amatus/rfidbadge/README.md

# RFID badge for DEF CON

## Controls

Press MENU to enter the menu system and to advance the selection.
Press SELECT to activate the selection.

Hold MENU to adjust the LCD contrast down (if the screen is all black).
Hold SELECT to adjust the LCD contrast up (if the screen is too light).
