amatus/rfidbadge/rfidbadge.brd

## EAGLE design rfidbadge.brd (2016-07-03)

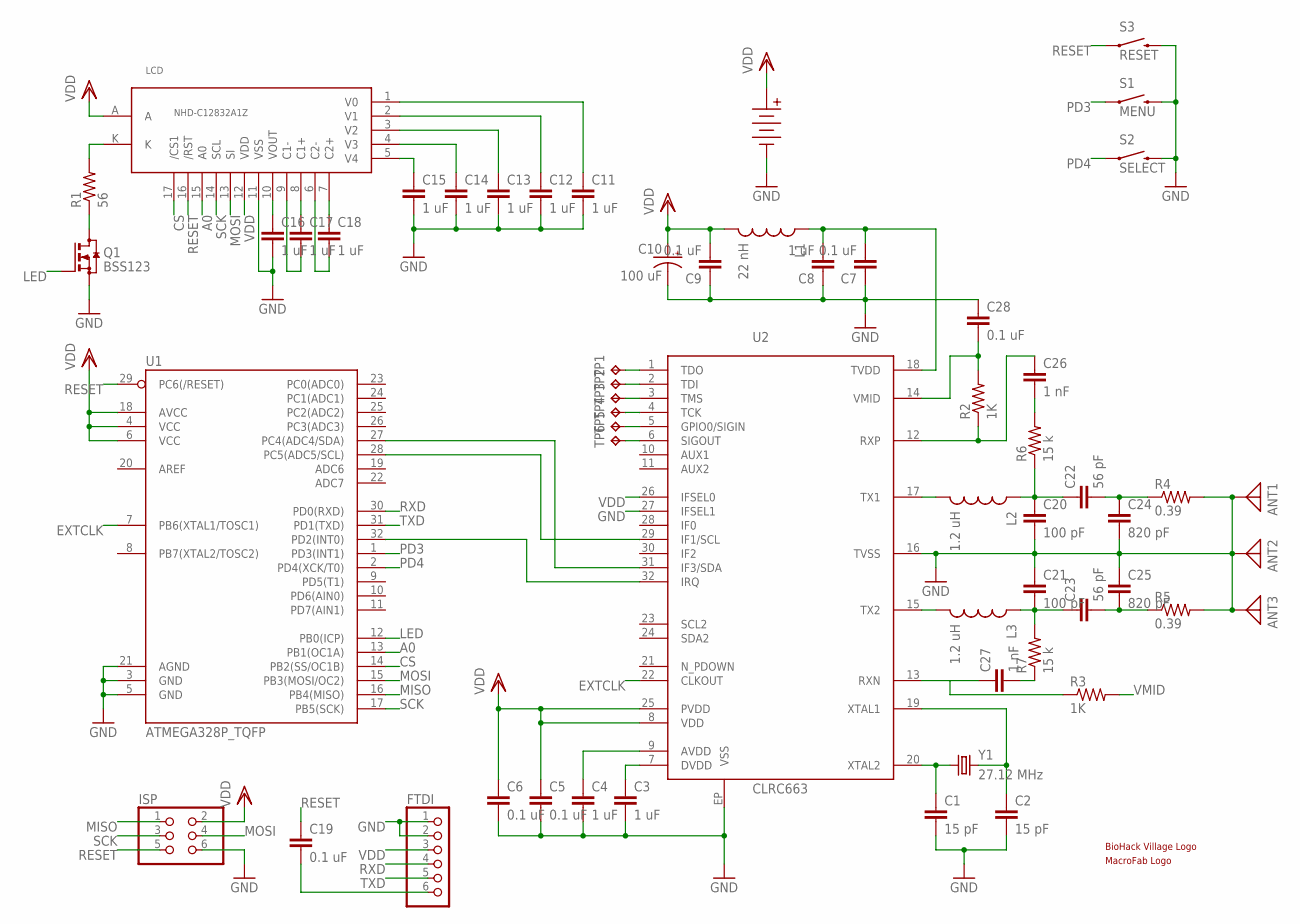
[picture p1: schematic rfidbadge.sch]

Parts:
ANT1, ANT2, ANT3: ANTENNA; PAD-01
BAT: AAA_X3
C1, C2: 15 pF; C0603K
C3, C4, C8, C11, C12, C13, C14, C15, C16, C17, C18: 1 uF; C0603K
C5, C6, C7, C9, C19, C28: 0.1 uF; C0603K
C10: 100 uF; EIA7343
C20, C21: 100 pF; C0603K
C22, C23: 56 pF; C0603K
C24, C25: 820 pF; C0603K
C26, C27: 1 nF; C0603K
FTDI: PINHD-1X6; 1X06
ISP: PINHD-2X3; 2X03
L1: 22 nH; 0603
L2, L3: 1.2 uH; 0603
LCD: NHD-C12832A1Z
Q1: BSS123; SOT23
R1: 56; R0603
R2, R3: 1K; R0603
R4, R5: 0.39; R0603
R6, R7: 15 k; R0603
S1: MENU; TACTILE_SWITCH_TALL
S2: SELECT; TACTILE_SWITCH_TALL
S3: RESET; TACTILE-SWITCH-1101NE
TP1, TP2, TP3, TP4, TP5, TP6: TPTP06R; TP06R
U1: ATMEGA328P_TQFP; TQFP32-08
U2: CLRC663; QFN32
U$1: BHVLOGO
U$2: MACROFABLOGO
Y1: 27.12 MHz; CRYSTAL-SMD-5X3

Connections:
A0: LCD.15 (A0), U1.13 (PB1(OC1A))
C1+: C17.1, LCD.8 (C1+)
C1-: C17.2, LCD.9 (C1-)
C2+: C18.1, LCD.7 (C2+)
C2-: C18.2, LCD.6 (C2-)
CS: LCD.17 (/CS1), U1.14 (PB2(SS/OC1B))
EXTCLK: U1.7 (PB6(XTAL1/TOSC1)), U2.22 (CLKOUT)
GND: ANT1.1, ANT2.1, ANT3.1, BAT.NEG, C1.2, C2.2, C3.2, C4.2, C5.2, C6.2, C7.1, C8.1, C9.1, C10.C (-), C11.2, C12.2, C13.2, C14.2, C15.2, C16.2, C20.2, C21.1, C24.2, C25.1, C28.1, FTDI.1, FTDI.2, ISP.6, LCD.11 (VSS), Q1.2 (S), R4.2, R5.2, S1.B2 (2), S2.B2 (2), S3.2, U1.3 (GND), U1.5 (GND), U1.21 (AGND), U2.16 (TVSS), U2.27 (IFSEL1), U2.EP (VSS)
K: LCD.K, R1.2
LED: Q1.1 (G), U1.12 (PB0(ICP))
MISO: ISP.1, U1.16 (PB4(MISO))
MOSI: ISP.4, LCD.13 (SI), U1.15 (PB3(MOSI/OC2))
unnamed: C20.1, C22.1, L2.1, R6.1
unnamed: C21.2, C23.1, L3.1, R7.2
unnamed: C22.2, C24.1, R4.1
unnamed: C23.2, C25.2, R5.1
unnamed: TP1.TP, U2.1 (TDO)
unnamed: TP2.TP, U2.2 (TDI)
unnamed: C26.2, R6.2
unnamed: C27.2, R7.1
unnamed: C27.1, R3.1, U2.13 (RXN)
unnamed: C4.1, U2.9 (AVDD)
unnamed: C3.1, U2.7 (DVDD)
unnamed: TP3.TP, U2.3 (TMS)
unnamed: TP4.TP, U2.4 (TCK)
unnamed: TP5.TP, U2.5 (GPIO0/SIGIN)
unnamed: TP6.TP, U2.6 (SIGOUT)
unnamed: Q1.3 (D), R1.1
unnamed: C19.2, FTDI.6
PD2: U1.32 (PD2(INT0)), U2.32 (IRQ)
PD3: S1.A2 (1), U1.1 (PD3(INT1))
PD4: S2.A2 (1), U1.2 (PD4(XCK/T0))
RESET: C19.1, ISP.5, LCD.16 (/RST), S3.1, U1.29 (PC6(/RESET))
RXD: FTDI.4, U1.30 (PD0(RXD))
RXP: C26.1, R2.1, U2.12 (RXP)
SCK: ISP.3, LCD.14 (SCL), U1.17 (PB5(SCK))
SCL: U1.28 (PC5(ADC5/SCL)), U2.29 (IF1/SCL)
SDA: U1.27 (PC4(ADC4/SDA)), U2.31 (IF3/SDA)
TVDD: C7.2, C8.2, L1.1, U2.18 (TVDD)
TX1: L2.2, U2.17 (TX1)
TX2: L3.2, U2.15 (TX2)
TXD: FTDI.5, U1.31 (PD1(TXD))
V0: C11.1, LCD.1 (V0)
V1: C12.1, LCD.2 (V1)
V2: C13.1, LCD.3 (V2)
V3: C14.1, LCD.4 (V3)
V4: C15.1, LCD.5 (V4)
VDD: BAT.POS, C5.1, C6.1, C9.2, C10.A (+), FTDI.3, ISP.2, L1.2, LCD.12 (VDD), LCD.A, U1.4 (VCC), U1.6 (VCC), U1.18 (AVCC), U2.8 (VDD), U2.25 (PVDD), U2.26 (IFSEL0)
VMID: C28.2, R2.2, R3.2, U2.14 (VMID)
VOUT: C16.1, LCD.10 (VOUT)
XTAL1: C2.1, U2.19 (XTAL1), Y1.3 (2)
XTAL2: C1.1, U2.20 (XTAL2), Y1.1

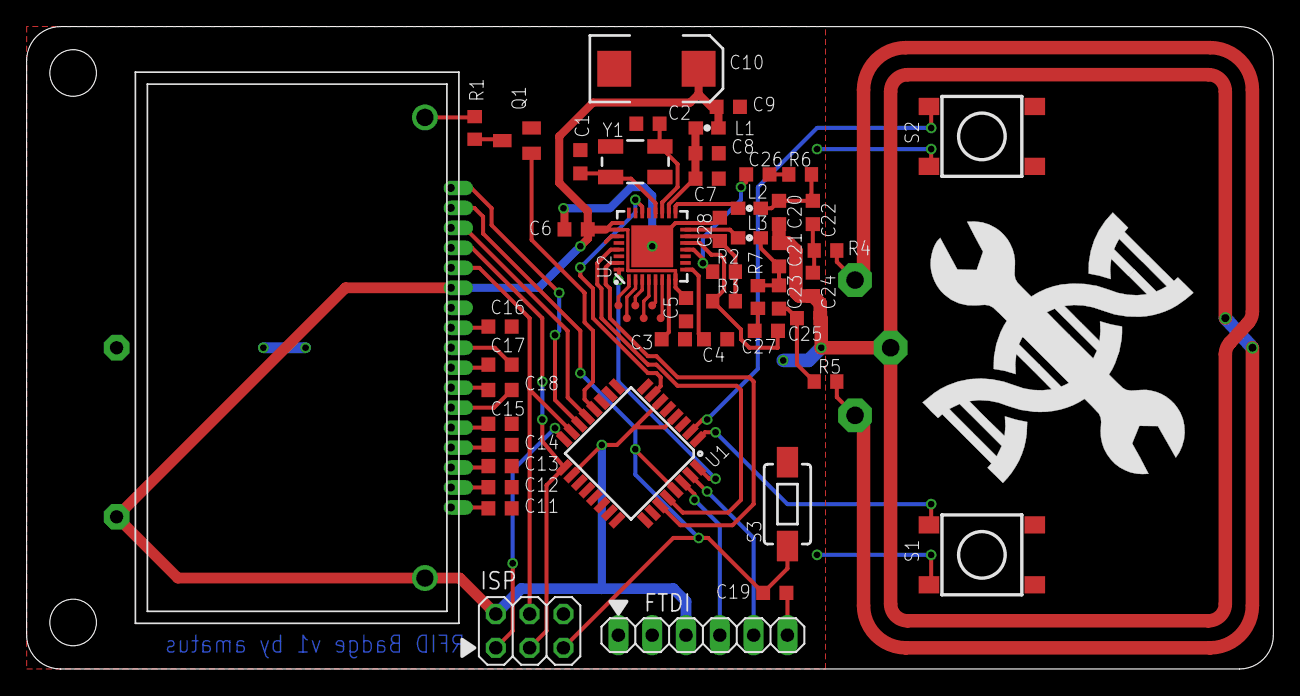
[picture p2: board rfidbadge.brd from above]

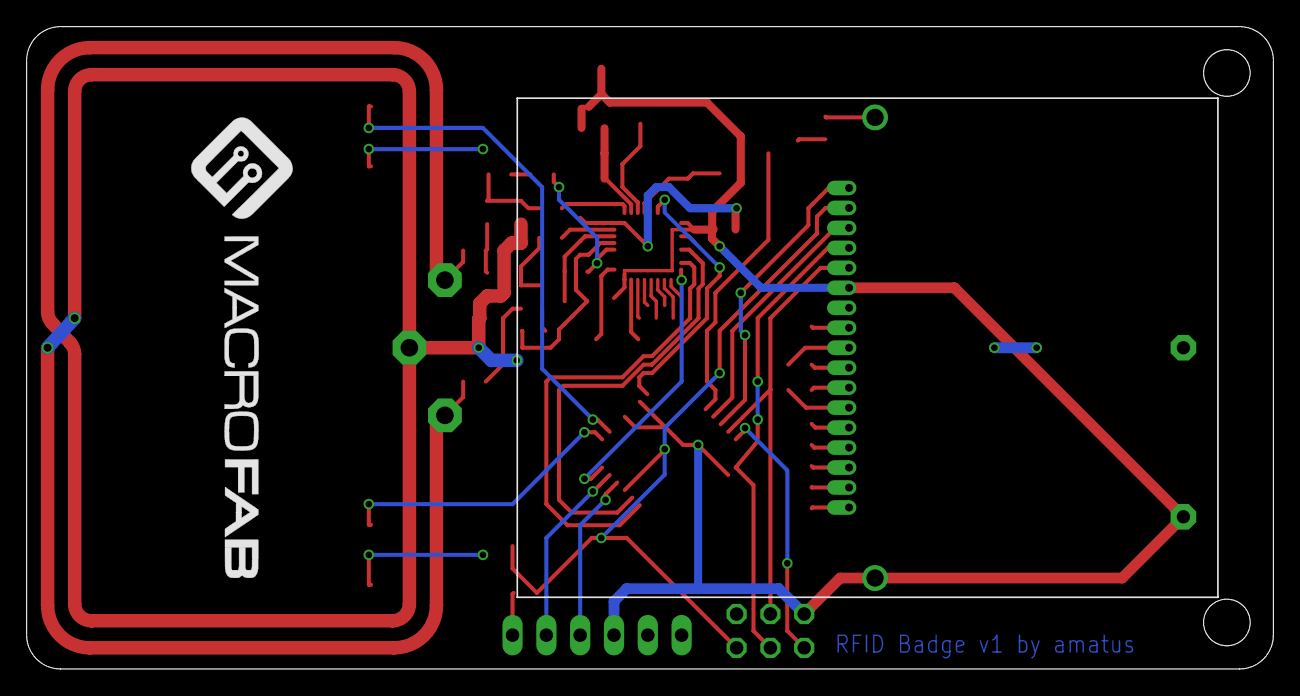
[picture p3: board rfidbadge.brd from below]

Board: 2 copper layers, 93.7 x 48.2 mm, 60 parts (2 on the bottom side), 52 nets.
