amatus/rfidbadge/programmer/program.h

0x940C,0x02E2,0x940C,0x030A,0x940C,0x030A,0x940C,0x030A,
0x940C,0x030A,0x940C,0x030A,0x940C,0x030A,0x940C,0x030A,
0x940C,0x030A,0x940C,0x030A,0x940C,0x030A,0x940C,0x030A,
0x940C,0x030A,0x940C,0x030A,0x940C,0x030A,0x940C,0x030A,
0x940C,0x0E95,0x940C,0x030A,0x940C,0x104D,0x940C,0x1090,
0x940C,0x030A,0x940C,0x030A,0x940C,0x030A,0x940C,0x030A,
0x940C,0x0CA7,0x940C,0x030A,0x0000,0x0000,0x7C00,0xF2DA,
0x7CDA,0xD67C,0xD6F2,0x387C,0x3E7C,0x387C,0x3C18,0x3C7E,
0x3818,0xBEEA,0x38EA,0x7A38,0x7AFE,0x0038,0x3C18,0x0018,
0xE7FF,0xE7C3,0x00FF,0x2418,0x0018,0xE7FF,0xE7DB,0x0CFF,
0x5C12,0x7060,0x9464,0x949E,0x0264,0xA0FE,0xE0A0,0xFE02,
0xA4A0,0x5AFC,0xE73C,0x5A3C,0x7CFE,0x3838,0x1010,0x3838,
0xFE7C,0x4428,0x44FE,0xFA28,0x00FA,0xFAFA,0x9060,0x80FE,
0x00FE,0x9166,0x56A9,0x0606,0x0606,0x2906,0xFF45,0x2945,
0x2010,0x207E,0x0810,0x7E04,0x0804,0x1010,0x3854,0x1010,
0x5438,0x1010,0x0878,0x0808,0x3008,0x3078,0x3078,0x1C0C,
0x1C7C,0x600C,0x7C70,0x6070,0x0000,0x0000,0x0000,0xFA00,
0x0000,0xE000,0xE000,0x2800,0x28FE,0x28FE,0x5424,0x54FE,
0xC448,0x10C8,0x4626,0x926C,0x046A,0x000A,0xE010,0x00C0,
0x3800,0x8244,0x0000,0x4482,0x0038,0x3854,0x38FE,0x1054,
0x7C10,0x1010,0x0100,0x0C0E,0x1000,0x1010,0x1010,0x0000,
0x0606,0x0400,0x1008,0x4020,0x8A7C,0xA292,0x007C,0xFE42,
0x0002,0x924E,0x9292,0x8462,0x9282,0xCCB2,0x2818,0xFE48,
0xE408,0xA2A2,0x9CA2,0x523C,0x9292,0x828C,0x8884,0xE090,
0x926C,0x9292,0x626C,0x9292,0x7894,0x0000,0x0028,0x0000,
0x2C02,0x0000,0x1000,0x4428,0x2882,0x2828,0x2828,0x8200,
0x2844,0x4010,0x9A80,0x6090,0x827C,0x9ABA,0x3E72,0x8848,
0x3E48,0x92FE,0x9292,0x7C6C,0x8282,0x4482,0x82FE,0x8282,
0xFE7C,0x9292,0x8292,0x90FE,0x9090,0x7C80,0x8282,0xCE8A,
0x10FE,0x1010,0x00FE,0xFE82,0x0082,0x0204,0xFC82,0xFE80,
0x2810,0x8244,0x02FE,0x0202,0xFE02,0x3840,0xFE40,0x20FE,
0x0810,0x7CFE,0x8282,0x7C82,0x90FE,0x9090,0x7C60,0x8A82,
0x7A84,0x90FE,0x9498,0x6462,0x9292,0x4C92,0x80C0,0x80FE,
0xFCC0,0x0202,0xFC02,0x04F8,0x0402,0xFCF8,0x1C02,0xFC02,
0x28C6,0x2810,0xC0C6,0x1E20,0xC020,0x9A86,0xB292,0x00C2,
0x82FE,0x8282,0x2040,0x0810,0x0004,0x8282,0xFE82,0x4020,
0x4080,0x0220,0x0202,0x0202,0xC000,0x10E0,0x0400,0x2A2A,
0x021E,0x14FE,0x2222,0x1C1C,0x2222,0x1422,0x221C,0x1422,
0x1CFE,0x2A2A,0x182A,0x1000,0x907E,0x1840,0x2525,0x1E39,
0x10FE,0x2020,0x001E,0xBE22,0x0002,0x0204,0xBC02,0xFE00,
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
