amatus/rfidbadge/programmer/bootloader.h

0x2411,0xB784,0xBE14,0xFF81,0xD0F0,0xE085,0x9380,0x0081,
0xE082,0x9380,0x00C0,0xE188,0x9380,0x00C1,0xE086,0x9380,
0x00C2,0xE180,0x9380,0x00C4,0xE08E,0xD0C9,0x9A25,0xE086,
0xE320,0xEF3C,0xE091,0x9330,0x0085,0x9320,0x0084,0xBB96,
0x9BB0,0xCFFE,0x9A1D,0x95A8,0x5081,0xF7A9,0x24CC,0x24DD,
0x2488,0x9483,0xE0B5,0x2EAB,0xE1A1,0x2E9A,0xE0F3,0x2EBF,
0xD0A2,0x3481,0xF461,0xD09F,0x2F08,0xD0AF,0x3802,0xF011,
0x3801,0xF411,0xE084,0xC001,0xE083,0xD08D,0xC089,0x3482,
0xF411,0xE184,0xC003,0x3485,0xF419,0xE085,0xD0A6,0xC080,
0x3585,0xF479,0xD088,0x2EE8,0x24FF,0xD085,0x2F08,0xE010,
0x2F10,0x2700,0x290E,0x291F,0x0F00,0x1F11,0xD08E,0x0168,
0xC06F,0x3586,0xF421,0xE084,0xD090,0xE080,0xCFDE,0x3684,
0xF009,0xC040,0xD070,0xD06F,0x2F08,0xD06D,0xE080,0x16C8,
0xE780,0x06D8,0xF418,0x01F6,0xBEB7,0x95E8,0xE0C0,0xE0D1,
0xD062,0x9389,0x170C,0xF7E1,0xE0F0,0x16CF,0xE7F0,0x06DF,
0xF018,0x01F6,0xBEB7,0x95E8,0xD068,0xB607,0xFC00,0xCFFD,
0x01A6,0xE0A0,0xE0B1,0x912C,0xE030,0x9611,0x918C,0x9711,
0xE090,0x2F98,0x2788,0x2B82,0x2B93,0x9612,0x01FA,0x010C,
0xBE87,0x95E8,0x2411,0x5F4E,0x4F5F,0xE0F1,0x38A0,0x07BF,
0xF751,0x01F6,0xBEA7,0x95E8,0xB607,0xFC00,0xCFFD,0xBE97,
0x95E8,0xC026,0x3784,0xF4B1,0xD02E,0xD02D,0x2EF8,0xD02B,
0xD03C,0x01F6,0x2CEF,0x018F,0x5F0F,0x4F1F,0x9184,0xD01B,
0x94EA,0x01F8,0xF7C1,0x9408,0x1CC1,0x1CD1,0x94FA,0x0CCF,
0x1CD1,0xC00E,0x3785,0xF439,0xD028,0xE18E,0xD00C,0xE985,
0xD00A,0xE08F,0xCF7A,0x3581,0xF411,0xE088,0xD018,0xD01D,
0xE180,0xD001,0xCF65,0x2F98,0x9180,0x00C0,0xFF85,0xCFFC,
0x9390,0x00C6,0x9508,0x9180,0x00C0,0xFF87,0xCFFC,0x9180,
0x00C0,0xFD84,0xC001,0x95A8,0x9180,0x00C6,0x9508,0xE6E0,
0xE0F0,0xE198,0x8390,0x8380,0x9508,0xDFED,0x3280,0xF019,
0xE088,0xDFF5,0xCFFF,0xE184,0xCFDE,0x931F,0x2F18,0xDFE3,
0x5011,0xF7E9,0xDFF2,0x911F,0x9508,0xE080,0xDFE8,0x27EE,
0x27FF,0x9409,
0x0404,
