amatus/rfidbadge/(commit log)

2016-05-03 ATmega328 and CLRC663 parts and a blank schematic
    [rfidbadge.sch]
2016-05-03 Wired up power and a crystal
    [rfidbadge.sch]
2016-05-03 Added display and wired up I2C
    [rfidbadge.sch]
2016-05-03 Add ISP and FTDI headers
    [rfidbadge.sch]
2016-05-04 Add antenna circuit
    [rfidbadge.sch]
2016-05-04 Add AAAx3 battery holder
    [rfidbadge.sch]
2016-05-04 Interrupted in the middle of starting the board
    [rfidbadge.brd, rfidbadge.sch]
2016-05-06 Lots of layout
    [rfidbadge.brd, rfidbadge.sch]
2016-05-10 Add antenna trace and ground planes
    [rfidbadge.brd, rfidbadge.sch]
2016-05-10 Finish routing
    [rfidbadge.brd, rfidbadge.sch]
2016-05-11 Add switches, lanyard holes, rounded corners
    [rfidbadge.brd, rfidbadge.sch]
2016-05-13 I like fat traces and I cannot lie
    [rfidbadge.brd]
2016-05-14 Added some test pads
    [rfidbadge.brd, rfidbadge.sch]
2016-05-15 Fix ground loops and islands
    [rfidbadge.brd]
2016-05-18 Fix button grounds
    [rfidbadge.brd]
2016-05-25 Some part values
    [rfidbadge.brd, rfidbadge.sch]
2016-05-25 Values and part numbers complete
    [rfidbadge.brd, rfidbadge.sch]
2016-05-26 Switch part number
    [rfidbadge.brd, rfidbadge.sch]
2016-05-28 Fix orphaned ground plane
    [rfidbadge.brd]
2016-06-03 Test Arduino sketch
2016-06-04 Send request type A and print results
2016-06-07 Adjust contrast for 4.5V
2016-06-08 Connect IRQ line, move buttons
    [rfidbadge.brd, rfidbadge.sch]
2016-06-08 Place part names
    [rfidbadge.brd]
2016-06-08 Add reset switch
    [rfidbadge.brd, rfidbadge.sch]
2016-06-10 Test buttons
2016-06-10 Make holes big enough for lobster claw
    [rfidbadge.brd]
2016-06-11 Add Defcon 24 logo
    [rfidbadge.brd, rfidbadge.sch]
2016-06-11 Fix artwork
    [rfidbadge.brd, rfidbadge.sch]
2016-06-11 Add CAM job
    [rfidbadge.brd]
2016-06-24 Replace DEF CON 24 logo with BioHack Village logo
    [rfidbadge.brd, rfidbadge.sch]
2016-06-25 Indicate pin 1 on the headers
    [rfidbadge.brd]
2016-06-27 Add MacroFab logo and cam job
    [rfidbadge.brd, rfidbadge.sch]
2016-07-03 Increase diameter of BAT annulus for soldering
    [rfidbadge.brd, rfidbadge.sch]
2016-07-16 Refactor interrupt code a bit
2016-07-26 Fix bool -> boolean
    [rfidbadge.ino]
